Angus-McIntyre/ESPLionV1/OpenBCI_KiCad_library_files/3D_Models/PTS810SJK250SMTR_LFS.stp

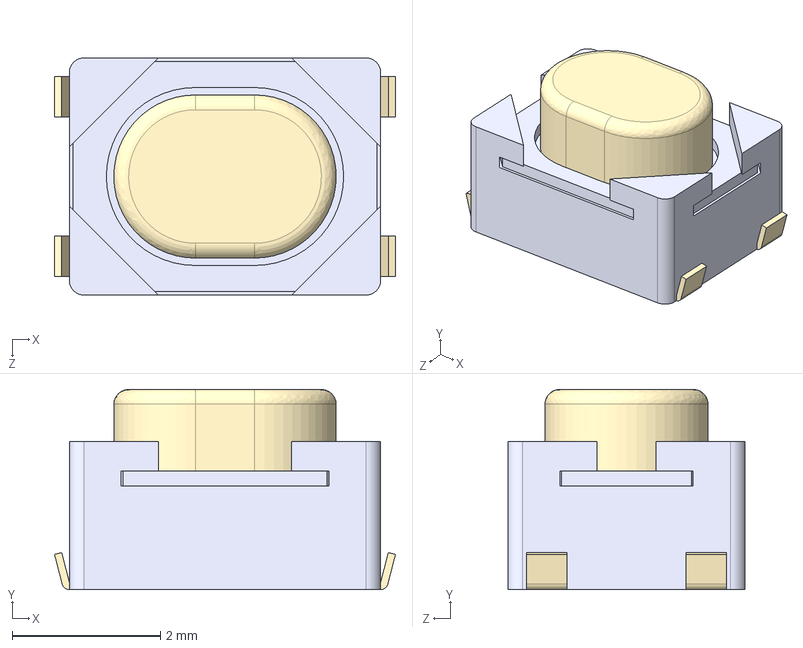
[picture p2: CAD file, 2025-06-01]
OpenBCI_KiCad_library_files/3D_Models/PTS810SJK250SMTR_LFS.stp
4.60 x 2.70 x 3.20 mm
