Angus-McIntyre/ESPLionV1/OpenBCI_KiCad_library_files/3D_Models/S3B-PH-SM4-TB.STEP

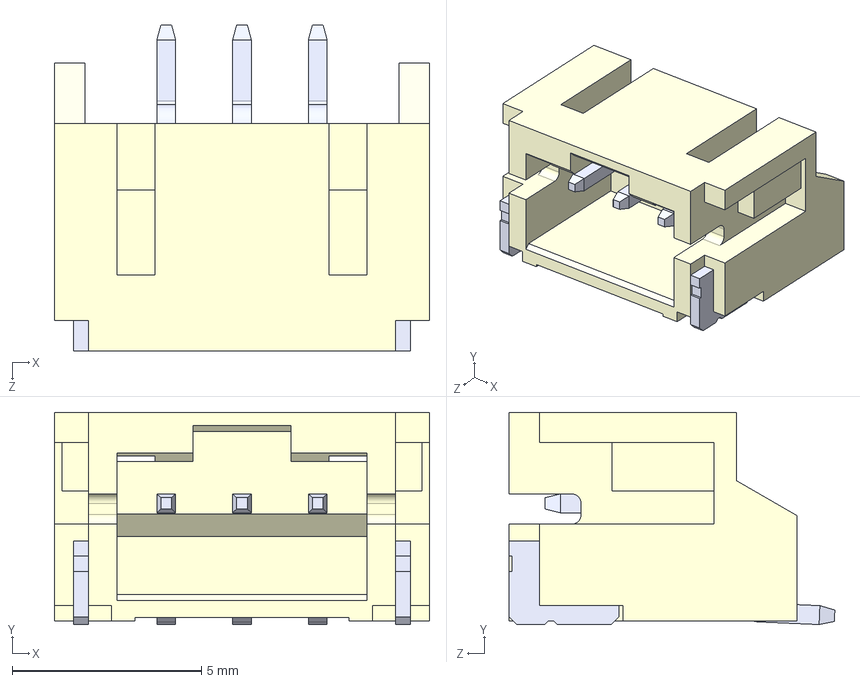
[picture p3: CAD file, 2025-06-01]
OpenBCI_KiCad_library_files/3D_Models/S3B-PH-SM4-TB.STEP
9.90 x 5.60 x 8.60 mm
