Angus-McIntyre/ESPLionV1/OpenBCI_KiCad_library_files/3D_Models/CJS-1200TA.STEP

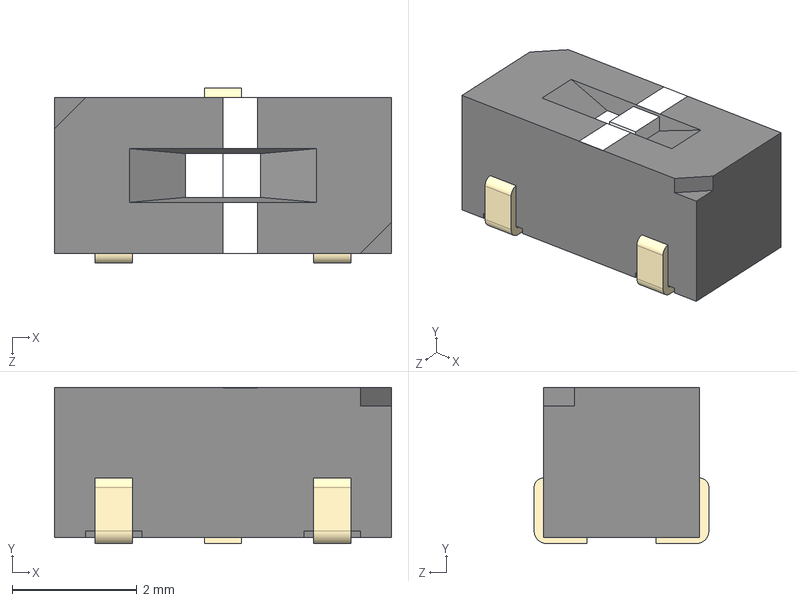
[picture p4: CAD file, 2025-06-01]
OpenBCI_KiCad_library_files/3D_Models/CJS-1200TA.STEP
5.40 x 2.50 x 2.80 mm
