Angus-McIntyre/ESPLionV1/OpenBCI_KiCad_library_files/3D_Models/SSSS810701.stp

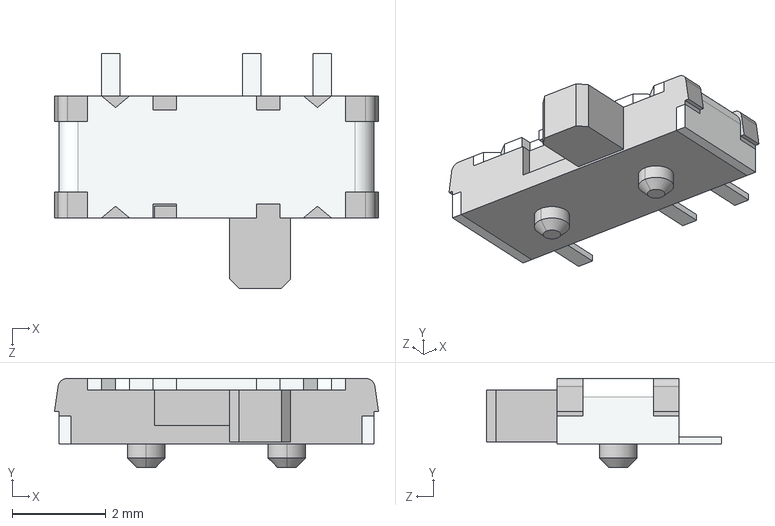
[picture p5: CAD file, 2025-06-01]
OpenBCI_KiCad_library_files/3D_Models/SSSS810701.stp
6.90 x 1.90 x 5.00 mm
