Angus-McIntyre/ESPLionV1/ESPLionV1.kicad_pcb

## KiCad design ESPLionV1.kicad_pcb (2025-06-01)

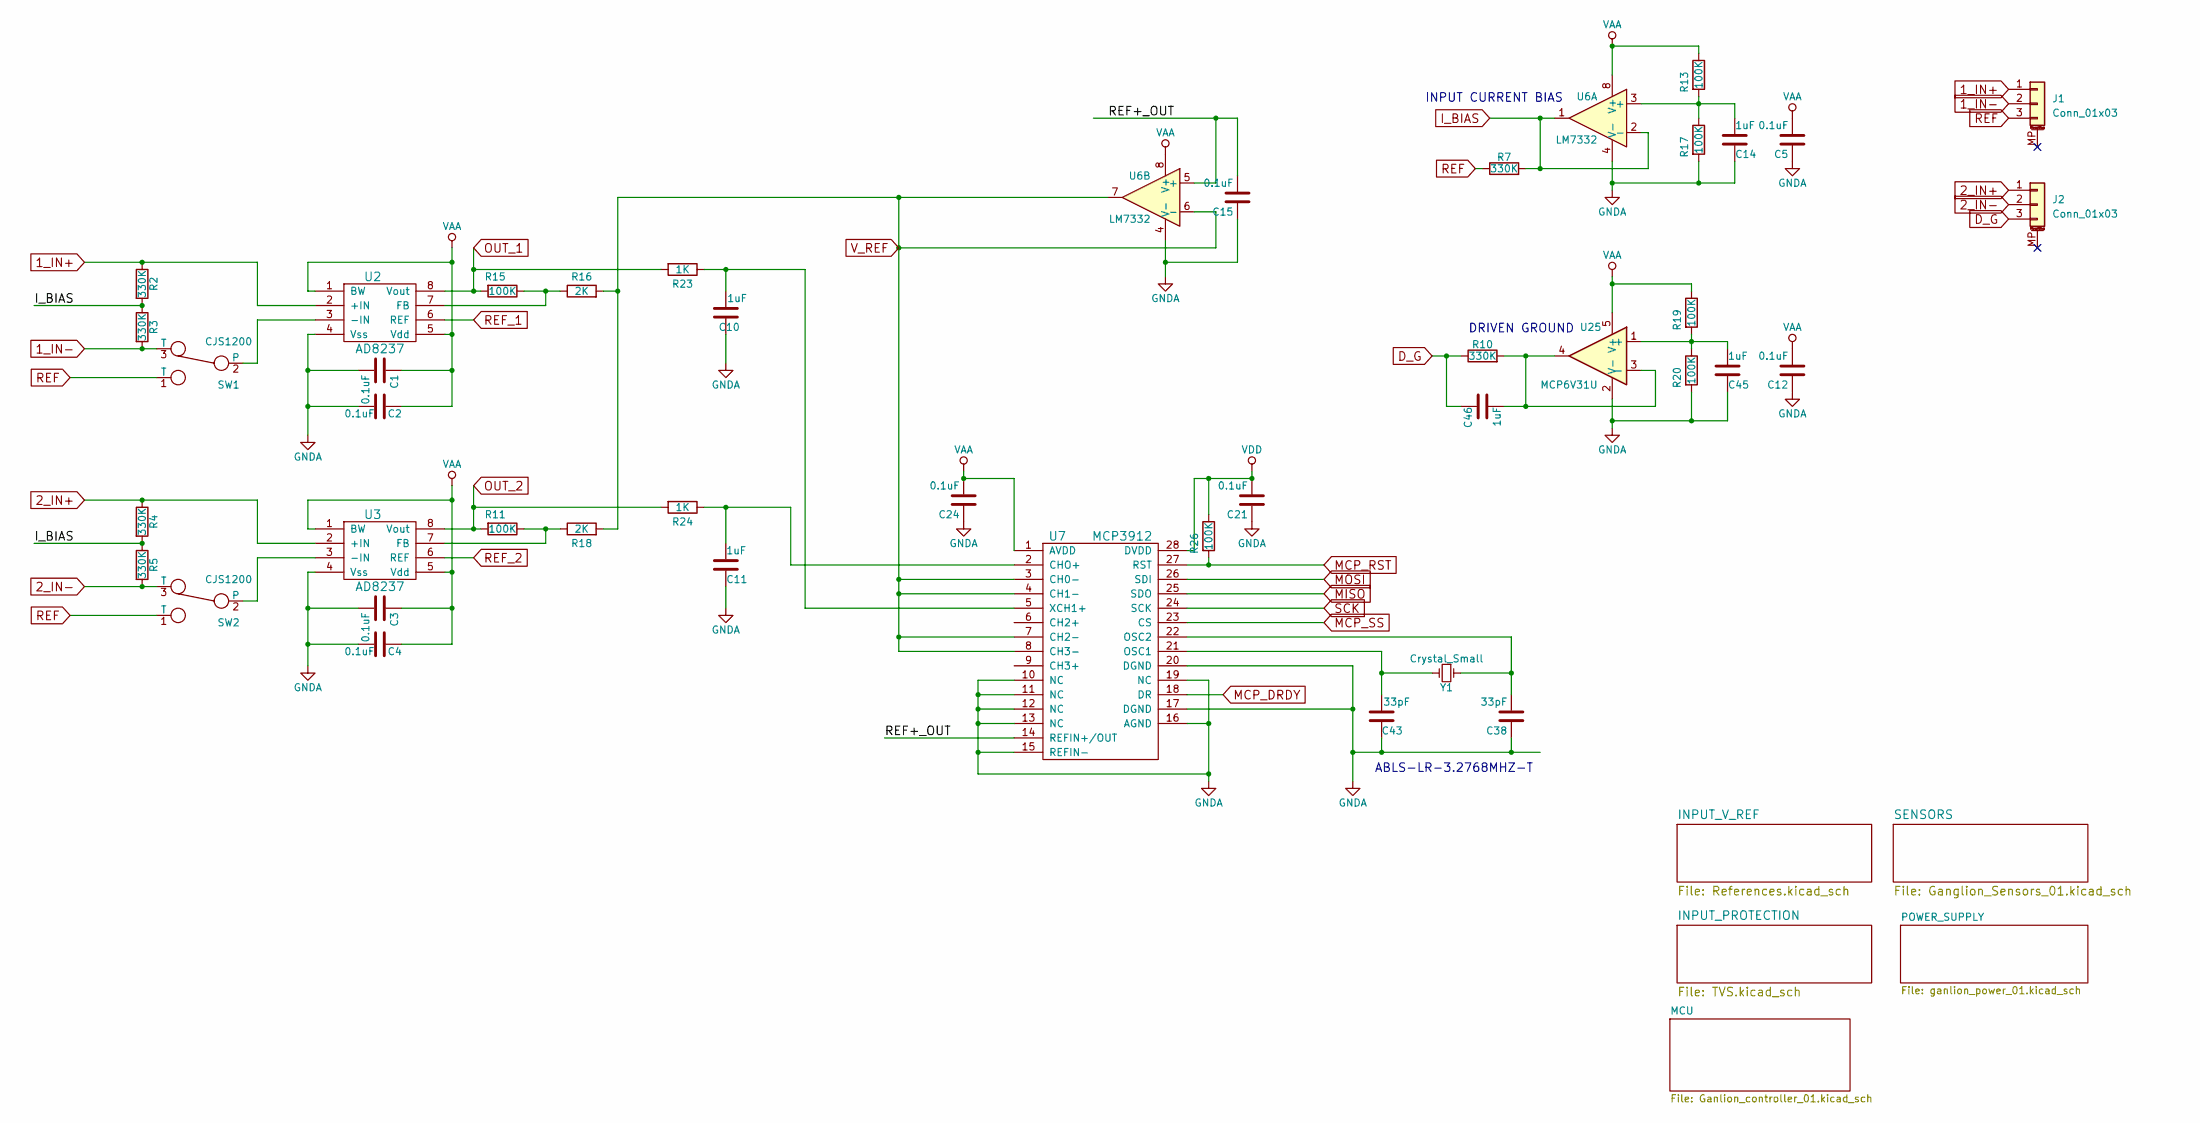
[picture p6: schematic ESPLionV1.kicad_sch, Ganglion]

Parts:
C1, C2, C3, C4, C5, C12, C15, C21, C24: 0.1uF; C_0402_1005Metric; MPN GRM155R71C104KA88J
C10, C11, C14, C45, C46: 1uF; C_0603_1608Metric; MPN CC0603KRX7R7BB105
C38, C43: 33pF; C_0603_1608Metric; MPN CL10C330JB8NNNC
J1, J2: Conn_01x03; JST_PH_S3B-PH-SM4-TB_1x03-1MP_P2.00mm_Horizontal; MPN S3B-PH-SM4-TB
R2, R3, R4, R5, R7, R10: 330K; R_0402_1005Metric; MPN ERJ-2RKF3303X
R11, R13, R15, R17, R19, R20, R26: 100K; R_0402_1005Metric; MPN ERJ-2RKF1003X
R16, R18: 2K; R_0402_1005Metric; MPN ERJ-2RKF2001X
R23, R24: 1K; R_0402_1005Metric; MPN ERJ-2RKF1001X
SW1, SW2: CJS1200; CJS-1200TA; MPN CJS-1200TA
U2, U3: AD8237; MSOP-8_3x3mm_P0.65mm; MPN AD8237ARMZ
U6: LM7332; MSOP-8_3x3mm_P0.65mm; MPN LM7332MMX/NOPB
U7: MCP3912; SSOP-28_5.3x10.2mm_P0.65mm; MPN MCP3912A1-E/SS
U25: MCP6V31U; SOT-353_SC-70-5; MPN MCP6V31UT-E/LT
Y1: Crystal_Small; Crystal_SMD_HC49-SD; MPN ABLS-LR-3.2768MHZ-T

Connections:
1_IN+: J1.1, R2.1, U2.2 (+IN); also elsewhere on the board
1_IN-: J1.2, R3.2, SW1.3 (T); also elsewhere on the board
2_IN+: J2.1, R4.1, U3.2 (+IN); also elsewhere on the board
2_IN-: J2.2, R5.2, SW2.3 (T); also elsewhere on the board
/REF+_OUT: C15.2, U6.5 (+), U7.14 (REFIN+/OUT)
D_G: C46.2, J2.3, R10.1; also elsewhere on the board
GNDA: C1.2, C2.2, C3.2, C4.2, C5.1, C10.1, C11.2, C12.1, C14.2, C15.1, C21.1, C24.1, C38.1, C43.1, C45.2, R17.2, R20.2, U2.4 (Vss), U3.4 (Vss), U6.4 (V-), U7.10 (NC), U7.11 (NC), U7.12 (NC), U7.13 (NC), U7.15 (REFIN-), U7.16 (AGND), U7.17 (DGND), U7.19 (NC), U7.20 (DGND), U25.2 (V-); also elsewhere on the board
I_BIAS: R2.2, R3.1, R4.2, R5.1, R7.2, U6.1, U6.2 (-)
MCP_DRDY: U7.18 (DR); also elsewhere on the board
MCP_RST: R26.2, U7.27 (RST); also elsewhere on the board
MCP_SS: U7.23 (CS); also elsewhere on the board
MISO: U7.25 (SDO); also elsewhere on the board
MOSI: U7.26 (SDI); also elsewhere on the board
unnamed: SW1.2, U2.3 (-IN)
unnamed: SW2.2, U3.3 (-IN)
unnamed: R15.1, R16.1, U2.7 (FB)
unnamed: R11.1, R18.1, U3.7 (FB)
unnamed: C14.1, R13.2, R17.1, U6.3 (+)
unnamed: C11.1, R24.1, U7.2 (CHO+)
unnamed: C43.2, U7.21 (OSC1), Y1.2
unnamed: C38.2, U7.22 (OSC2), Y1.1
unnamed: C10.2, R23.1, U7.5 (XCH1+)
unnamed: C45.1, R19.2, R20.1, U25.1 (+)
unnamed: C46.1, R10.2, U25.3 (-), U25.4
OUT_1: R15.2, R23.2, U2.8 (Vout); also elsewhere on the board
OUT_2: R11.2, R24.2, U3.8 (Vout); also elsewhere on the board
REF: J1.3, R7.1, SW1.1 (T), SW2.1 (T); also elsewhere on the board
REF_1: U2.6 (REF); also elsewhere on the board
REF_2: U3.6 (REF); also elsewhere on the board
SCK: U7.24 (SCK); also elsewhere on the board
VAA: C1.1, C2.1, C3.1, C4.1, C5.2, C12.2, C24.2, R13.1, R19.1, U2.1 (BW), U2.5 (Vdd), U3.1 (BW), U3.5 (Vdd), U6.8 (V+), U7.1 (AVDD), U25.5 (V+); also elsewhere on the board
VDD: C21.2, R26.1, U7.28 (DVDD); also elsewhere on the board
V_REF: R16.2, R18.2, U6.6 (-), U6.7, U7.3 (CH0-), U7.4 (CH1-), U7.7 (CH2-), U7.8 (CH3-); also elsewhere on the board

Notes on the sheet:
INPUT CURRENT BIAS
ABLS-LR-3.2768MHZ-T
DRIVEN GROUND

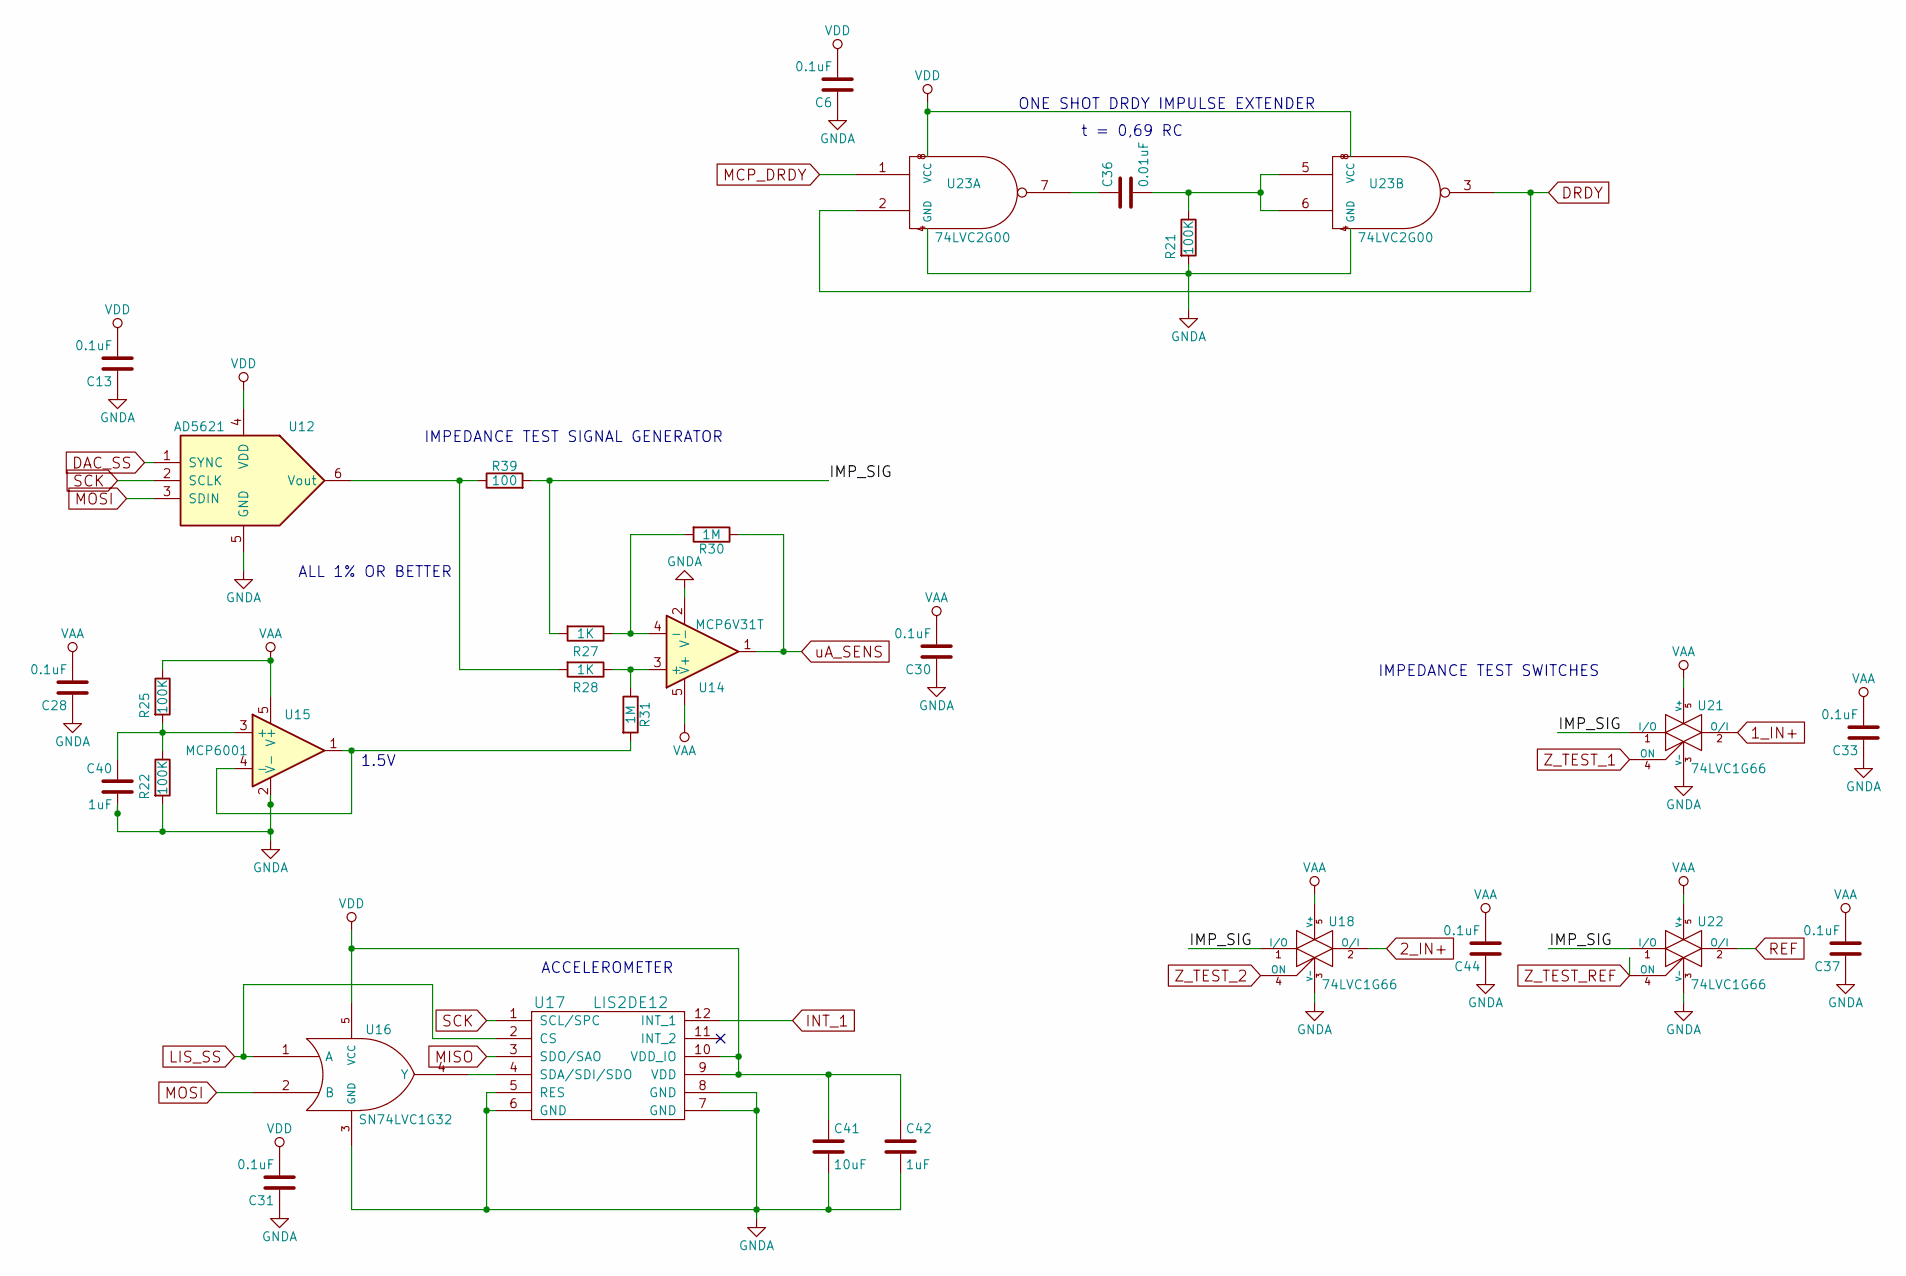
[picture p7: schematic Ganglion_Sensors_01.kicad_sch, Ganglion Peripherals]

Parts:
C6, C13, C28, C30, C31, C33, C37, C44: 0.1uF; C_0402_1005Metric; MPN GRM155R71C104KA88J
C36: 0.01uF; C_0603_1608Metric; MPN GCM188R72A103KA37D
C40, C42: 1uF; C_0603_1608Metric; MPN CC0603KRX7R7BB105
C41: 10uF; C_0603_1608Metric; MPN GRM188R60J106KE47D
R21, R22, R25: 100K; R_0402_1005Metric; MPN ERJ-2RKF1003X
R27, R28: 1K; R_0402_1005Metric; MPN ERJ-2RKF1001X
R30, R31: 1M; R_0402_1005Metric; MPN ERJ-2RKF1004X
R39: 100; R_0603_1608Metric; MPN ERA-3AEB101V
U12: AD5621; SOT-363_SC-70-6; MPN AD5621AKSZ-REEL7
U14: MCP6V31T; SOT-23-5; MPN MCP6V31T-E/OT
U15: MCP6001; SOT-353_SC-70-5; MPN MCP6001T-I/LT
U16: SN74LVC1G32; SOT-353_SC-70-5; MPN SN74LVC1G32DCKR
U17: LIS2DE12; LIS2DH12; MPN LIS2DE12TR
U18, U21, U22: 74LVC1G66; SOT-353_SC-70-5; MPN 74LVC1G66GW,125
U23: 74LVC2G00; VSSOP-8; MPN SN74LVC2G00DCUR

Connections:
1_IN+: U21.2 (O/I); also elsewhere on the board
2_IN+: U18.2 (O/I); also elsewhere on the board
/SENSORS/IMP_SIG: R27.2, R39.2, U18.1 (I/O), U21.1 (I/O), U22.1 (I/O)
DAC_SS: U12.1 (SYNC); also elsewhere on the board
DRDY: U23.2, U23.3; also elsewhere on the board
GNDA: C6.1, C13.1, C28.1, C30.1, C31.1, C33.1, C37.1, C40.2, C41.2, C42.2, C44.1, R21.2, R22.2, U12.5 (GND), U14.2 (V-), U15.2 (V-), U16.3 (GND), U17.5 (RES), U17.6 (GND), U17.7 (GND), U17.8 (GND), U18.3 (V-), U21.3 (V-), U22.3 (V-), U23.4 (GND); also elsewhere on the board
INT_1: U17.12 (INT_1); also elsewhere on the board
LIS_SS: U16.1 (A), U17.2 (CS); also elsewhere on the board
MCP_DRDY: U23.1; also elsewhere on the board
MISO: U17.3 (SDO/SAO); also elsewhere on the board
MOSI: U12.3 (SDIN), U16.2 (B); also elsewhere on the board
unnamed: C36.1, U23.7
unnamed: C36.2, R21.1, U23.5, U23.6
unnamed: R28.2, R39.1, U12.6 (Vout)
unnamed: R28.1, R31.1, U14.3 (+)
unnamed: R27.1, R30.2, U14.4 (-)
unnamed: C40.1, R22.1, R25.2, U15.3 (+)
unnamed: R31.2, U15.1, U15.4 (-)
unnamed: U16.4 (Y), U17.4 (SDA/SDI/SDO)
REF: U22.2 (O/I); also elsewhere on the board
SCK: U12.2 (SCLK), U17.1 (SCL/SPC); also elsewhere on the board
VAA: C28.2, C30.2, C33.2, C37.2, C44.2, R25.1, U14.5 (V+), U15.5 (V+), U18.5 (V+), U21.5 (V+), U22.5 (V+); also elsewhere on the board
VDD: C6.2, C13.2, C31.2, C41.1, C42.1, U12.4 (VDD), U16.5 (VCC), U17.9 (VDD), U17.10 (VDD_IO), U23.8 (VCC); also elsewhere on the board
Z_TEST_1: U21.4 (ON); also elsewhere on the board
Z_TEST_2: U18.4 (ON); also elsewhere on the board
Z_TEST_REF: U22.4 (ON); also elsewhere on the board
uA_SENS: R30.1, U14.1; also elsewhere on the board

Notes on the sheet:
ONE SHOT DRDY IMPULSE EXTENDER
t = 0,69 RC
1.5V
ACCELEROMETER
IMPEDANCE TEST SIGNAL GENERATOR
ALL 1% OR BETTER
IMPEDANCE TEST SWITCHES

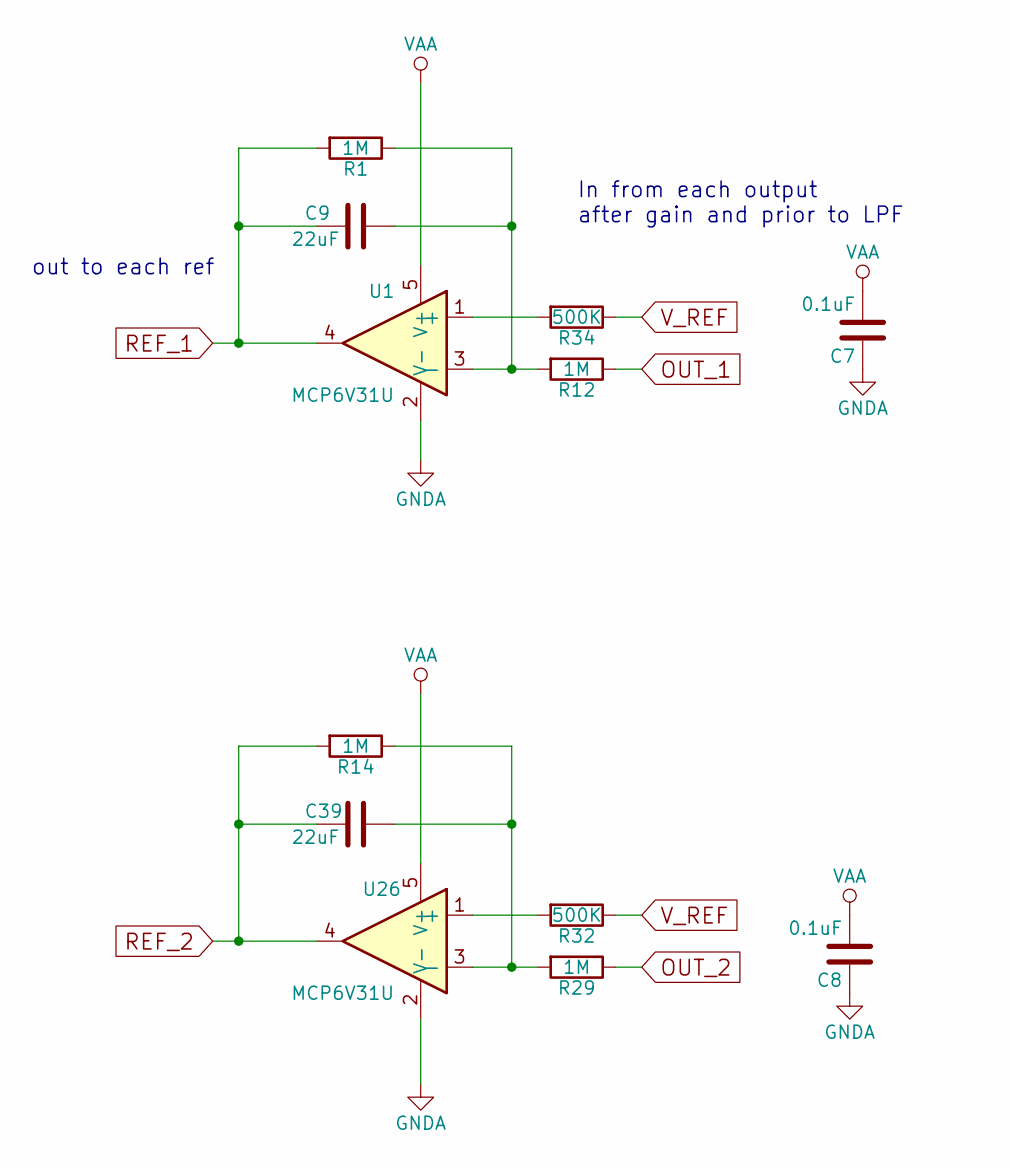
[picture p8: schematic References.kicad_sch, Ganglion Input Voltage References]

Parts:
C7, C8: 0.1uF; C_0402_1005Metric; MPN GRM155R71C104KA88J
C9, C39: 22uF; C_0603_1608Metric; MPN GRM188R60J226MEA0D
R1, R12, R14, R29: 1M; R_0402_1005Metric; MPN ERJ-2RKF1004X
R32, R34: 500K; R_0402_1005Metric; MPN ERJ-2RKF4993X
U1, U26: MCP6V31U; SOT-353_SC-70-5; MPN MCP6V31UT-E/LT

Connections:
GNDA: C7.1, C8.1, U1.2 (V-), U26.2 (V-); also elsewhere on the board
unnamed: R34.2, U1.1 (+)
unnamed: C9.1, R1.1, R12.2, U1.3 (-)
unnamed: R32.2, U26.1 (+)
unnamed: C39.1, R14.1, R29.2, U26.3 (-)
OUT_1: R12.1; also elsewhere on the board
OUT_2: R29.1; also elsewhere on the board
REF_1: C9.2, R1.2, U1.4; also elsewhere on the board
REF_2: C39.2, R14.2, U26.4; also elsewhere on the board
VAA: C7.2, C8.2, U1.5 (V+), U26.5 (V+); also elsewhere on the board
V_REF: R32.1, R34.1; also elsewhere on the board

Notes on the sheet:
In from each output after gain and prior to LPF
out to each ref

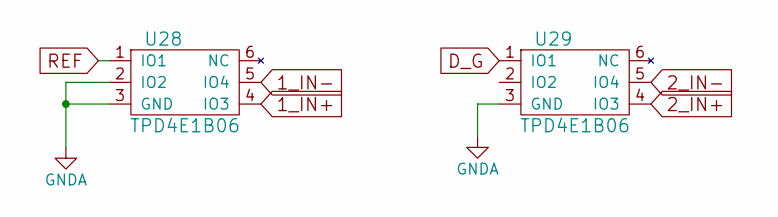
[picture p9: schematic TVS.kicad_sch, Ganglion Input Protection]

Parts:
U28, U29: TPD4E1B06; SOT-363_SC-70-6; MPN TPD4E1B06DCKR

Connections:
1_IN+: U28.4 (IO3); also elsewhere on the board
1_IN-: U28.5 (IO4); also elsewhere on the board
2_IN+: U29.4 (IO3); also elsewhere on the board
2_IN-: U29.5 (IO4); also elsewhere on the board
D_G: U29.1 (IO1); also elsewhere on the board
GNDA: U28.2 (IO2), U28.3 (GND), U29.3 (GND); also elsewhere on the board
REF: U28.1 (IO1); also elsewhere on the board

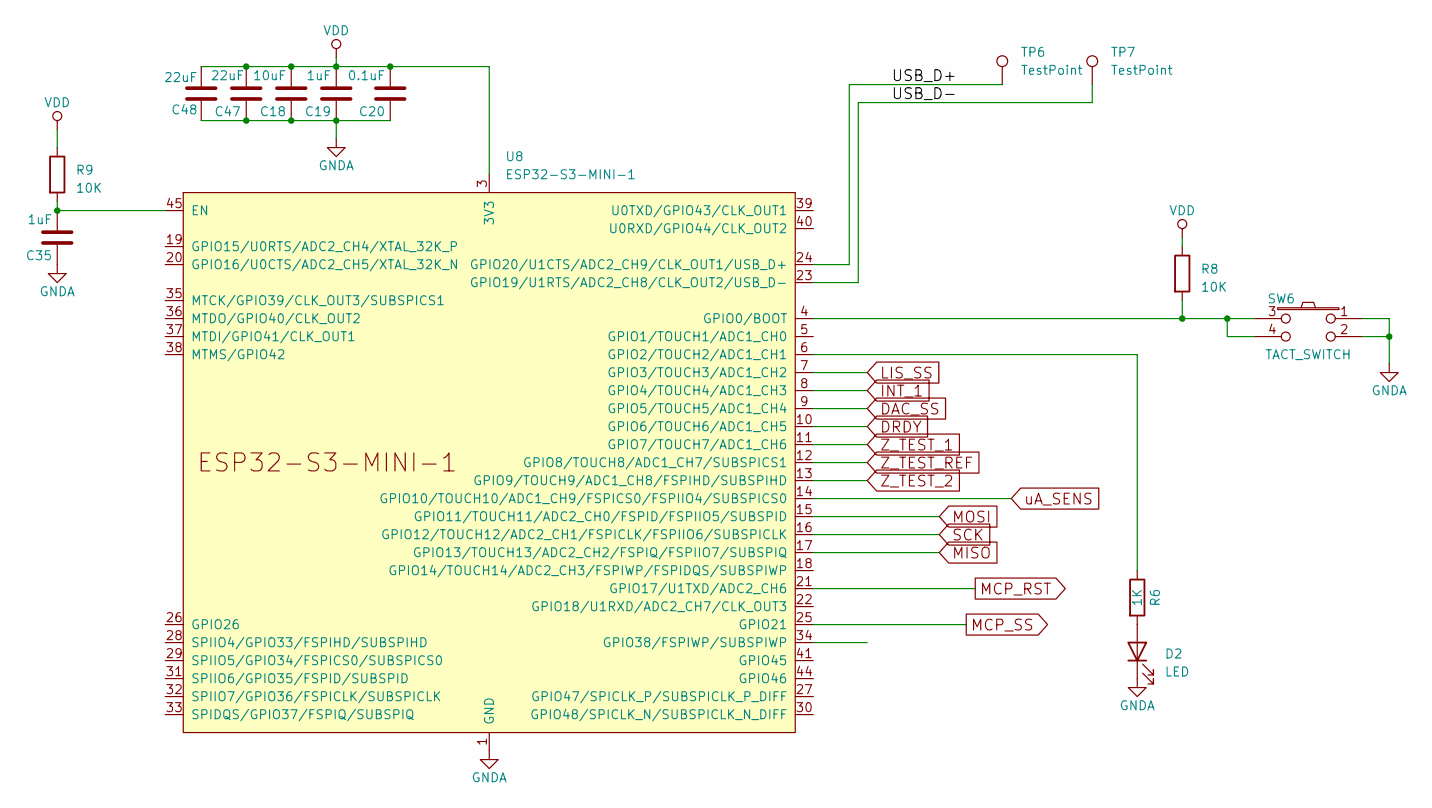
[picture p10: schematic Ganlion_controller_01.kicad_sch]

Parts:
C18: 10uF; C_0603_1608Metric; MPN GRM188R60J106KE47D
C19, C35: 1uF; C_0603_1608Metric; MPN CC0603KRX7R7BB105
C20: 0.1uF; C_0402_1005Metric; MPN GRM155R71C104KA88J
C47, C48: 22uF; C_0603_1608Metric; MPN GRM188R60J226MEA0D
D2: LED; LED_0603_1608Metric_Pad1.05x0.95mm_HandSolder; MPN 150060VS75003
R6: 1K; R_0402_1005Metric; MPN ERJ-2RKF1001X
R8, R9: 10K; R_0402_1005Metric; MPN ERJ-2RKF1002X
SW6: TACT_SWITCH; PTS810; MPN PTS810 SJK 250 SMTR LFS
TP6, TP7: TestPoint; TestPoint_Pad_D1.5mm
U8: ESP32-S3-MINI-1; MPN ESP32-S3-MINI-1-N8

Connections:
/MCU/USB_D+: TP6.1, U8.24 (GPIO20/U1CTS/ADC2_CH9/CLK_OUT1/USB_D+)
/MCU/USB_D-: TP7.1, U8.23 (GPIO19/U1RTS/ADC2_CH8/CLK_OUT2/USB_D-)
DAC_SS: U8.9 (GPIO5/TOUCH5/ADC1_CH4); also elsewhere on the board
DRDY: U8.10 (GPIO6/TOUCH6/ADC1_CH5); also elsewhere on the board
GNDA: C18.1, C19.1, C20.1, C35.1, C47.2, C48.2, D2.1 (K), SW6.1, SW6.2, U8.1 (GND), U8.2 (GND), U8.42 (GND), U8.43 (GND), U8.46 (GND), U8.47 (GND), U8.48 (GND), U8.49 (GND), U8.50 (GND), U8.51 (GND), U8.52 (GND), U8.53 (GND), U8.54 (GND), U8.55 (GND), U8.56 (GND), U8.57 (GND), U8.58 (GND), U8.59 (GND), U8.60 (GND), U8.61 (GND), U8.62 (GND), U8.63 (GND), U8.64 (GND), U8.65 (GND); also elsewhere on the board
INT_1: U8.8 (GPIO4/TOUCH4/ADC1_CH3); also elsewhere on the board
LIS_SS: U8.7 (GPIO3/TOUCH3/ADC1_CH2); also elsewhere on the board
MCP_RST: U8.21 (GPIO17/U1TXD/ADC2_CH6); also elsewhere on the board
MCP_SS: U8.25 (GPIO21); also elsewhere on the board
MISO: U8.17 (GPIO13/TOUCH13/ADC2_CH2/FSPIQ/FSPIIO7/S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); also elsewhere on the board
MOSI: U8.15 (GPIO11/TOUCH11/ADC2_CH0/FSPID/FSPIIO5/S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); also elsewhere on the board
unnamed: D2.2 (A), R6.2
unnamed: C35.2, R9.2, U8.45 (EN)
unnamed: R8.2, SW6.3, SW6.4, U8.4 (GPIO0/BOOT)
unnamed: R6.1, U8.6 (GPIO2/TOUCH2/ADC1_CH1)
SCK: U8.16 (GPIO12/TOUCH12/ADC2_CH1/FSPICLK/FSPIIO6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); also elsewhere on the board
VDD: C18.2, C19.2, C20.2, C47.1, C48.1, R8.1, R9.1, U8.3 (3V3); also elsewhere on the board
Z_TEST_1: U8.11 (GPIO7/TOUCH7/ADC1_CH6); also elsewhere on the board
Z_TEST_2: U8.13 (GPIO9/TOUCH9/ADC1_CH8/FSPIHD/SUBSPIHD); also elsewhere on the board
Z_TEST_REF: U8.12 (GPIO8/TOUCH8/ADC1_CH7/SUBSPICS1); also elsewhere on the board
uA_SENS: U8.14 (GPIO10/TOUCH10/ADC1_CH9/FSPICS0/FSPIIO4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); also elsewhere on the board

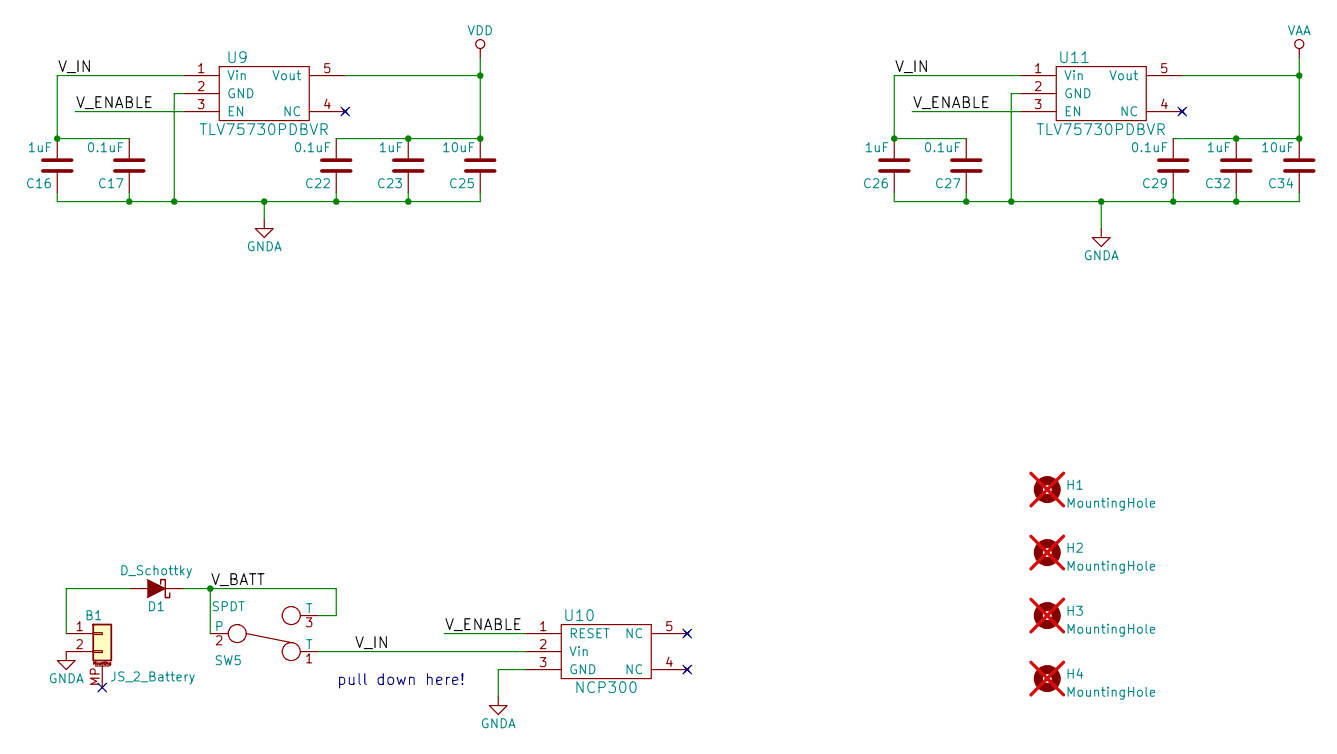
[picture p11: schematic ganlion_power_01.kicad_sch]

Parts:
B1: JS_2_Battery; JST_PH_S2B-PH-SM4-TB_1x02-1MP_P2.00mm_Horizontal; MPN S2B-PH-SM4-TB
C16, C23, C26, C32: 1uF; C_0603_1608Metric; MPN CC0603KRX7R7BB105
C17, C22, C27, C29: 0.1uF; C_0402_1005Metric; MPN GRM155R71C104KA88J
C25, C34: 10uF; C_0603_1608Metric; MPN GRM188R60J106KE47D
D1: D_Schottky; C_0603_1608Metric; MPN CDBU0130L
H1, H2, H3, H4: MountingHole; MountingHole_3.2mm_M3_Pad; not fitted
SW5: SPDT; SSSS810701_SSSS810701; MPN SSSS810701
U9, U11: TLV75730PDBVR; SOT-23-5; MPN TLV75730PDBVR
U10: NCP300; SOT-23-5; MPN BD4930G-TR

Connections:
/POWER_SUPPLY/V_BATT: D1.1 (K), SW5.2, SW5.3 (T)
/POWER_SUPPLY/V_ENABLE: U9.3 (EN), U10.1 (RESET), U11.3 (EN)
/POWER_SUPPLY/V_IN: C16.2, C17.2, C26.2, C27.2, SW5.1 (T), U9.1 (Vin), U10.2 (Vin), U11.1 (Vin)
GNDA: B1.2, C16.1, C17.1, C22.1, C23.1, C25.1, C26.1, C27.1, C29.1, C32.1, C34.1, U9.2 (GND), U10.3 (GND), U11.2 (GND); also elsewhere on the board
unnamed: B1.1, D1.2 (A)
VAA: C29.2, C32.2, C34.2, U11.5 (Vout); also elsewhere on the board
VDD: C22.2, C23.2, C25.2, U9.5 (Vout); also elsewhere on the board

Notes on the sheet:
pull down here!

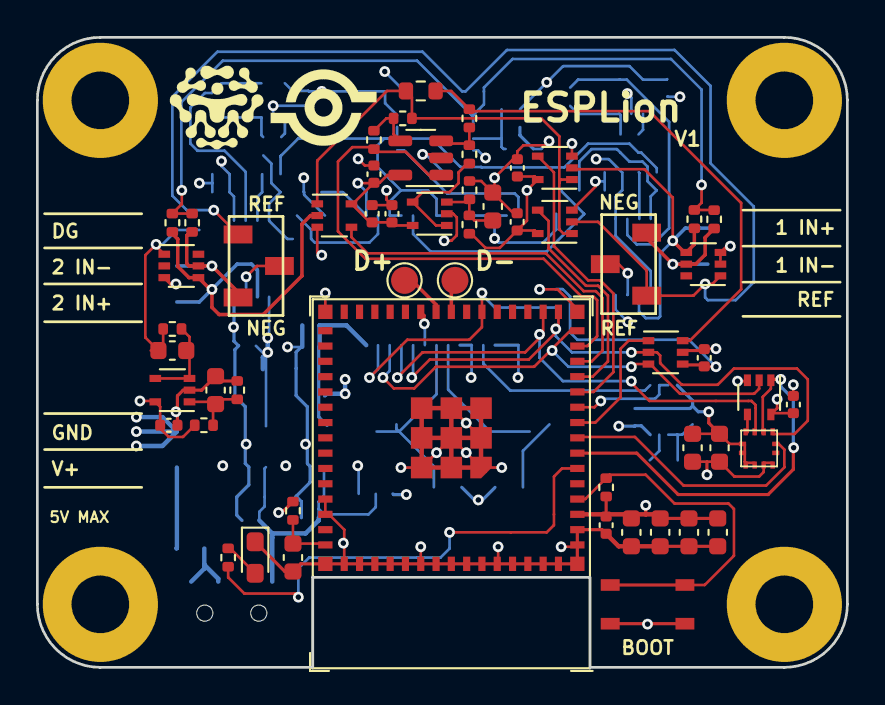
[picture p12: board ESPLionV1.kicad_pcb from above]

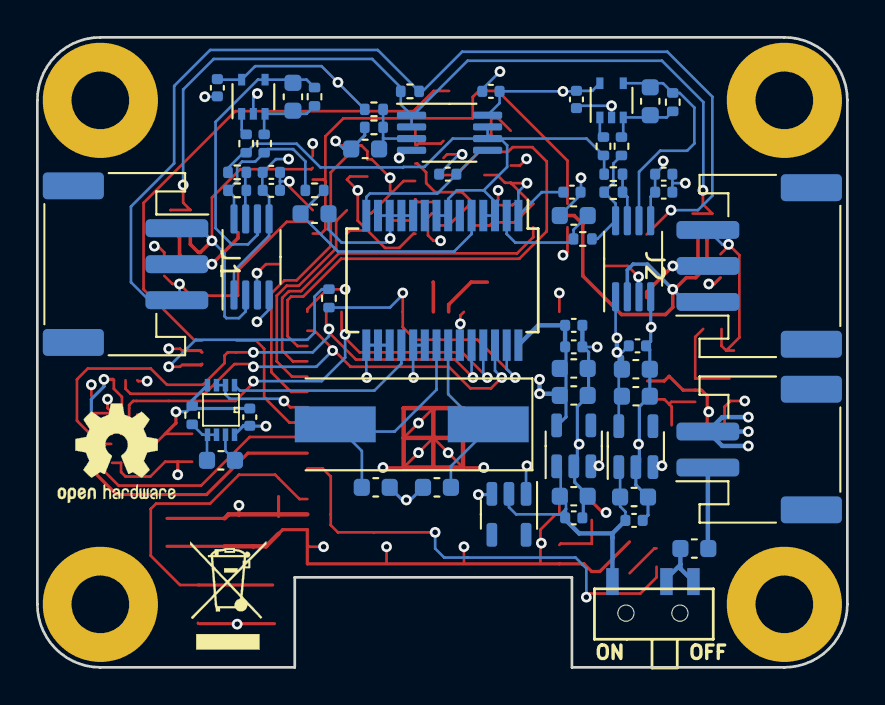
[picture p13: board ESPLionV1.kicad_pcb from below]

Board: 4 copper layers, 45.0 x 35.0 mm, 120 parts (62 on the bottom side), 64 nets.
