Angus-McIntyre/ESPLionV1/(commit log)

2025-06-01 BOM cleanup
    [BOM.csv, Ganglion_01.kicad_pcb, Ganglion_01.kicad_sch, Ganglion_Sensors_01.kicad_sch, Ganlion_controller_01.kicad_sch, ganlion_power_01.kicad_sch]
2025-06-01 Release files
    [BOM.csv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]
2025-06-01 Rename project
    [CJS-1200TA.STEP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]
2025-06-01 Clean up
    [BOM.csv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]
